Buia-Dev/PulseDash/Obsidian/Pulsedash/🏆 Log de Conquistas.md

# 🏆 Log de Conquistas

> Registro das vitórias técnicas mais importantes. Cada entrada aqui custou horas de debug, testes no carro e determinação. Não é programador, mas resolve! 💪

---

## 🥇 A Grande Conquista — CAN Bus Nativo (2026-05-16)

**O que foi:** Descartamos completamente o ELM327 Bluetooth e implementamos leitura **direta** da rede CAN do Onix 2026 usando o driver TWAI nativo do ESP32 com o módulo SN65HVD230.

**Por que é difícil:** O Onix 2026 usa um **Security Gateway** da GM que ignora frames CAN de 11-bit (padrão). Somente o endereçamento **Extended de 29-bit** com o endereço específico `0x18DB33F1` consegue comunicação.

**O momento:** Após horas de debug com logs de "ECU em silêncio", a tela mostrou:
```
[CAN] Handshake OK! ECU detectada: 0x18daf111
[CAN] ★ ONLINE! Dashboard ativo.
```

**Dados confirmados em tempo real:**
- Temperatura: **35°C** (motor frio) → **90°C** (temperatura normal)
- Acelerador: mudou de **43% → 26%** conforme o pedal foi liberado
- RPM máximo registrado: **6.418 RPM**
- Velocidade máxima registrada: **115 km/h**

---

## 🥈 Descoberta do GND do Chassi (2026-05)

**O que foi:** Semanas de frustração com "Driver OK mas sem resposta da ECU". O motivo era simples mas invisível: faltava conectar o **GND do pino 4/5 do OBD2** ao GND do ESP32.

**Lição:** Em sistemas CAN, o GND é a referência para os níveis de tensão diferencial (CAN-H e CAN-L). Sem ele, o transceiver literalmente não "vê" os bits.

---

## 🥉 Curto CAN-H/CAN-L (2026-05)

**O que foi:** Mesmo com o GND conectado, o driver entrava em Bus-Off imediato. A causa foi um curto físico nas pistas da PCB do conector OBD2 que havíamos adquirido.

**Solução:** Raspagem manual das pistas de cobre com uma chave de fenda até o curto desaparecer. Depois disso, o barramento estabilizou.

---

## 🎖️ Modularização do Frontend (v4.0)

**O que foi:** O arquivo `index.html` tinha crescido para quase 60KB com todo o CSS e JS embutido — impossível de manter. Dividimos em `state.js`, `renderers.js`, `editor.js` e `main.js`.

**Resultado:** Cada arquivo tem uma responsabilidade única. O código ficou 10x mais fácil de editar.

---

## 🎖️ PWA Funcional no Celular

**O que foi:** O dashboard agora pode ser instalado como app na tela inicial do celular (iOS e Android). Funciona com ícone personalizado, tela cheia sem barra do navegador e cache offline via Service Worker.

**Resultado:** Experiência idêntica a um app nativo sem precisar publicar na App Store.

---

## 🎖️ WebSocket em Tempo Real (v4.1 → v5.0)

**O que foi:** Migramos do polling HTTP (requisição a cada 1 segundo) para **WebSocket** (porta 81). O ESP32 empurra os dados automaticamente a cada 100ms.

**Resultado:** Os ponteiros do dashboard ficaram "vivos" — sem o salto brusco de 1 em 1 segundo.

---

## 🎖️ Integração e Ativação Plena das Ferramentas MCP (2026-05-20)

**O que foi:** Diagnosticamos e eliminamos os gargalos de execução nos servidores MCP integrados à IDE. Criamos a pasta global NPM em `AppData\Roaming\npm`, atualizamos o Node.js para **v24.15.0** e ativamos o Docker Desktop para o `github-mcp-server`.

**Resultado:** Ambos os servidores MCP estão 100% ativos, permitindo o pair-programming de IA no mais alto nível de engenharia.

---

## 🎖️ v6.2 — Sessão Épica de 3 Fases (2026-05-23)

Esta sessão foi a mais importante e produtiva do projeto. Dividida em 3 fases de implementação.

---

### ⚡ Fase 1 — Análise Claude + Refatoração Arquitetural

**O que foi:** O Claude deu uma nota **9.6/10** ao projeto e indicou o caminho para prepará-lo para o APK. Executamos todas as suas sugestões de alta prioridade:

**Extração de módulos de `main.js` (era 1.035 linhas → agora modular):**
- `trip.js` — Todo o Computador de Bordo (TRIP: distância, combustível, custo, timers)
- `perf.js` — Cronômetro 0-100 com state machine (IDLE→WAIT_STOP→READY→RUNNING→DONE), Top 5, histórico
- `transport.js` — Camada de abstração de comunicação (Bluetooth Serial nativo vs. WebSocket)

**Sistema de Orientações (Portrait/Landscape independentes):**
- Criado o objeto `orientations: { portrait: [...], landscape: [...] }` no estado global
- Cada orientação tem seu próprio layout de widgets completamente independente
- `swapOrientation()` refeito para limpar apenas camadas específicas, eliminando duplicação

**Correção do bug `w._sv` (suavização):**
- `saveToESP()` agora deleta `w._sv` antes de serializar a config
- `applyConfig()` limpa o `_sv` ao trocar de sensor para evitar suavização de valor errado

**UDS Service 22 (PIDs Proprietários GM):**
- `canReadUDS()` implementado para Temp. Câmbio (`0x1940`), Pressão Óleo (`0x115C`), Temp. Óleo (`0x1154`)
- `canSendUDS()` com frame correto de 8 bytes e endereço físico `0x18DA11F1`

**Fallback de Consumo Flex Estequiométrico:**
- Quando PID `0x5E` falha, calcula via MAF + Etanol%:
  - AFR dinâmico: `14.7*(1-eth) + 9.0*eth`
  - Densidade real: `737*(1-eth) + 789*eth` g/L
  - Resultado em L/h correto para qualquer mistura E0-E100

**Slosh Mitigation (mitigação de balanço do tanque):**
- 3 modos: Fast-Fill (abastecimento), Bloqueio Inercial (frenagem/aceleração), Suavização lenta (cruzeiro)
- Algoritmo EMA com pesos diferentes por cenário

---

### 🐛 Fase 2 — Debug de UI e Build do APK

**O que foi:** Série de bugs visuais e de build foram identificados e corrigidos:

**Ícones do APK com XML corrompido:**
- `ic_launcher.xml` e `ic_launcher_round.xml` tinham BOM UTF-8 que causava `XMLStreamException`
- Recriados do zero com XML limpo e layer-list correto

**Imagens personalizadas da galeria:**
- Usuário pode adicionar imagens da galeria do celular como fundo de relógio
- `LOCAL_IMAGES` expandido com suporte a `pulsedash_custom_images` no localStorage
- Mover, redimensionar e deletar imagens customizadas funcionando

**Duplicação de relógios ao girar o celular:**
- `swapOrientation()` chamava `innerHTML = ''` no container inteiro
- Corrigido para limpar apenas `wl-0`, `wl-1`, etc. (camadas específicas)

**Cores dos arcos/agulhas não salvavam:**
- `applyConfig()` pegava valores de inputs ocultos (`display:none`) e sobrescrevia as cores corretas
- Corrigido com filtro `if (input.offsetParent !== null)` antes de ler o valor

**Fontes +2px em tudo:**
- Script varreu `style.css` e incrementou em 2px todos os `font-size` do menu, overlays e etiquetas

**Botão ↔ no Editor:**
- Restaurado no cabeçalho do `#cpanel`
- `document.getElementById('cpanel').classList.toggle('right')` — alterna lado instantaneamente

---

### 🔧 Fase 3 — Compilação, Correção de Runtime e Teste no Carro

**O que foi:** Integração do `arduino-cli`, correção dos últimos bugs de runtime e validação final em pista.

**`arduino-cli` integrado ao Antigravity:**
- Download e configuração do core `esp32:esp32@3.3.8`
- Correção do `}` faltando no final da função `loop()` (engolido numa refatoração)
- Compilação bem-sucedida: **1.119.484 bytes (85% do flash)**, 42.136 bytes RAM (12%)
- Firmware `.bin` gerado em `APK/Firmware/PulseDashESP_BT.ino.bin`

**Bug `Script error. Linha: 0:0` (tela vermelha ao conectar BT):**
- Falso positivo do Android WebView ao carregar módulos ES6 com `import/export`
- O `window.onerror` recebia o evento sem arquivo, linha ou stack (segurança do browser)
- Fix: `if (e.message === 'Script error.' || (!e.filename && e.lineno === 0)) return;`

**Bug `_freqHz is not defined` (crash no menu OBD):**
- Variáveis `_freqHz`, `_freqCounter`, `_freqTimer`, `_blinkTimer` foram perdidas numa refatoração
- Declaradas no escopo global do `main.js`

**Repositório oficial sincronizado:**
- `PulseDashESP_BT/` contém apenas o `PulseDashESP_BT.ino` (sem pasta `data` do LittleFS)
- `APK/` contém `PulseDash_v6.2.apk` e `Firmware/PulseDashESP_BT.ino.bin`

**✅ TESTE NO CARRO — RESULTADO:** `"ja ta lendo certim"` — Buia, 2026-05-23

---

## 📊 Linha do Tempo do Projeto

```
[v1-v2] Canvas + Widgets simulados (sem hardware)
   ↓
[v3.x]  Integração ELM327 Bluetooth — funcionou mas com alta latência
   ↓
[v4.0]  Modularização JS + WebSocket + PWA
   ↓
[v5.0]  ★ MIGRAÇÃO TOTAL para CAN Bus 29-bit nativo
   ↓
[v5.1]  Otimizações de performance (100ms timeout, 20ms delay, 10 tentativas)
   ↓
[v5.4.1] Suavização por ponteiro, cronômetro 0-100
   ↓
[v6.0]  App Android nativo + Bluetooth Classic RFCOMM + Scheduler 10 slots
   ↓
[v6.2]  ★ SESSÃO ÉPICA: 3 fases — Arquitetura + Debug UI + Compilação CLI
         ★ PRIMEIRA SAÍDA DE RUA — Leitura confirmada no Onix 2026
   ↓
[v6.3]  Remoção de shadowBlur (Thermal Throttling) e Lazy Render otimizado
   ↓
[v6.4]  Separação de utils.js (Fim da dependência circular e silent crashes no Boot)
   ↓
[v6.6]  Fase de Performance Extrema e Otimização GPU (60FPS WebView sem drop-shadow)
   ↓
[v6.9]  ★ INTEGRAÇÃO DE AGULHAS & RELEASE DO APK v6.9 (16 agulhas, JBR compiler)

---

## 🎖️ A Batalha contra o Android WebView (v6.3 / v6.4)

**O que foi:** O app entrava em _thermal throttling_ após minutos de uso e congelava a tela no boot intermitentemente.
- **Thermal Throttling:** Identificamos que o `ctx.shadowBlur` nos Canvas causava um overhead colossal sem aceleração nativa na GPU, derretendo o CPU do celular. A remoção resolveu os travamentos em tempo de uso. Adicionamos **Lazy Render**, onde o `ctx` só é limpo e redesenhado se a variação do sensor for maior que `0.05`.
- **Silent Boot Crash:** Um erro silencioso e randômico no Android WebView estava ocorrendo devido a uma **Dependência Circular** (ES6 Modules) entre `main.js`, `trip.js` e `transport.js` que usavam o `toast()`. Extraímos tudo para um `utils.js` isolado e os travamentos do boot desapareceram completamente.

---

## 🎖️ Expansão de Performance e UI Premium (v6.5 / v6.6)

**O que foi:** Foco absoluto na fluidez visual, usabilidade do editor e suporte a novos sensores de performance.

**Fase de Editor e Usabilidade (v6.5):**
- **Collision Test Exato (Z-Index):** O clique de seleção no editor passou a priorizar os elementos menores e mais à frente (Point-in-Rectangle hit test com ordenação decrescente de área), facilitando selecionar elementos pequenos sobrepostos a grandes áreas.
- **Scroll e Pinned Buttons no Painel:** O `#cpanel` foi redesenhado com barra de rolagem high-tech interna. Botões de "SALVAR/DELETAR" e o título ficaram fixos (pinned) para sempre estarem visíveis, eliminando problemas de corte na parte inferior.
- **Opções Automáticas por Sensor:** Ao selecionar um sensor (ex: Velocidade, Modo Demo), as opções específicas de correção abrem instantaneamente na edição do widget sem necessidade de reabrir o menu.
- **Inércia Suavizada:** Slider substituído por um dropdown intuitivo (3%, 6%, 9% ou Sem Inércia).
- **Correções Visuais:** O botão "Mover/Travar" parou de sumir, e a borda amarela de seleção foi fixada garantindo retenção de estados pelo `mkWidget()`. E widgets independentes ganharam a própria velocidade de Modo Demo (`w.demoSpeed`).

**Fase de Performance Extrema e Otimização GPU (v6.6):**
- **Novos Sensores PRO:** Implementados decodificadores para `turbo`, `maf`, `oilPress`, `fuelPress`, `oilTemp`, `iat`, `egt`, `afr`, `lambda` e `timing`. Os cálculos de mistura e pressão de turbo já usam decimais nos relógios. Removidos sensores GPS retro para focar 100% no OBD2.
- **60FPS no Android WebView:** Diagnosticamos um grande gargalo na splash screen. O Android WebView congelava/lagava renderizando `-webkit-background-clip: text` junto de `filter: drop-shadow`. 
- **Solução Visual Elegante:** Trocamos todos os drop-shadows por `text-shadow` e `box-shadow`, recuperando os 60FPS estáveis na abertura sem perder a estética neon/synthwave.
- **Pausa Dramática (500ms):** Inserimos 500ms de tela preta pura antes da inicialização visual para evitar o engasgo inicial do aplicativo no celular e permitir que o usuário sempre aprecie a animação de "booting" do zero com sincronia perfeita.

---

**Links:** [[⚙️ Painel de Controle (Home)]] | [[📝 Lista de Tarefas]]  
**Tags:** #conquistas #historico #milestones #canbus #pulsedash

---

## 🎖️ Agulhas Premium & Compilação Autônoma (v6.9 - 2026-06-09)

**O que foi:** Adicionados 16 designs de agulha categorizados e configurados no painel com dropdown Figma-like, além de criar o pipeline de build e sync do APK v6.9.

**Fase de Design e Categorização das Agulhas:**
- **16 Estilos Aprovados:**
  - *Cor Variável:* Neon Glow (original), Traço Fino, Triângulo, Ponta Cor, Halo/Flutuante, Esqueleto GT3, Lâmina Laser.
  - *Cor Fixa:* Retro Cromo, Audi RS Red, Subaru STI Orange, Mercedes-AMG White, Corvette Yellow, Carbon Hex-Arrow.
  - *Pontas (Setas/Halos flutuantes):* Setinha Externa, Double Ring Arrow, Halo Dot, Chevron Sweep, Crosshair Radar, Laser Dot Trail, Diamond Prism, Arc Bracket.
- **Auto-Escala Proporcional:** Criado fator `sf = r / 138` para todas as agulhas.
- **Ajuste de Visibilidade de Pontas (+35%):** Agulhas do grupo "Pontas" receberam escala de ampliação automática de `1.35x` no canvas para melhorar legibilidade e legibilidade mobile.
- **Dropdown Agrupado (`<optgroup>`):** Seletor do editor reestruturado com categorias visuais divididas.

**Fase de Compilação Estável do APK v6.9:**
- **Injeção de Script Automática:** O script `sync.js` foi configurado para injetar `capacitor.js` dinamicamente no boot-file para evitar travamentos de dependências nativas.
- **Bypass de PowerShell Execution Policy:** Executado o sync via CMD (`npx.cmd cap sync android`) para contornar restrições de permissões no Windows.
- **Build de Release Debug v6.9:** Compilação finalizada via linha de comando local utilizando o compilador JDK JBR integrado ao Android Studio. O arquivo gerado foi arquivado em `APK/PulseDashV6.9.apk`.

---

## 🏆 A Grande Evolução — Telemetria Binária & Estabilização Geral (v7.0 - 2026-06-11)

**O que foi:** Expandimos o protocolo de comunicação para telemetria binária pura de 51 bytes, habilitamos 8 novos sensores de performance ativa e eliminamos completamente gargalos de escrita na Flash e JIT no WebView. A nota do projeto chegou em **10/10** no Nível 1.

**O que conquistamos:**
- **8 Novos Sensores Ativos (Prioridade 2):** Pressão e Temp de Óleo, Pressão de Combustível, Temperatura de Escape (EGT), Mistura AFR, Sensor Lambda, Timing de Ignição e Temperatura de Admissão (IAT) integrados com decodificação no firmware e calibração no app.
- **Criação da `fsTask` no Core 0 (Antilag de LittleFS):** Todas as escritas em disco da ESP32 (viagem de 5km, parada de motor, sensores não suportados, escrita de histórico no dia, e perfil do carro) foram movidas para a `fsTask` em segundo plano no Core 0, rodando sob mutex. Isso acabou em definitivo com as quedas bruscas de conexão e lag na telemetria.
- **Mitigação de Fragmentação de Heap (ESP32 Uptime Máximo):** Refatoramos o salvamento do histórico de 7 dias na Flash de Strings Arduino para um buffer estático em RAM `char[1024]` e `snprintf`. Uptime ilimitado sem risco de Out of Memory.
- **Overhead JIT Eliminado no WebView:** Fórmulas de conversão de dados agora usam JIT caching via Map local `formulaCache` no `transport.js`. O compilador `new Function` roda uma única vez por fórmula, poupando bateria e CPU do celular.
- **Interface e Controles Seguros:**
  - Delegação de cliques estáticos no Computador de Bordo (`trip.js`), reduzindo o vazamento de listeners e RAM no WebView.
  - Cancelamento de timers de terminal DTC com `clearDtcTimers()`, evitando o encavalamento de textos e concorrência no DOM.
  - Google DTC dinâmico por marca com `ST.car?.brand`.
- **Compilação e Lançamento do APK v7.0:** O Gradle compilou a versão 7.0 (código 7) sob o JDK do Android Studio e salvamos o APK v7.0 no repositório.

---

**Links:** [[⚙️ Painel de Controle (Home)]] | [[📝 Lista de Tarefas]] | [[🔌 Sensores e Comunicação]]  
**Tags:** #conquistas #historico #milestones #canbus #pulsedash #v70
