Buia-Dev/PulseDash/kline_image.jpg

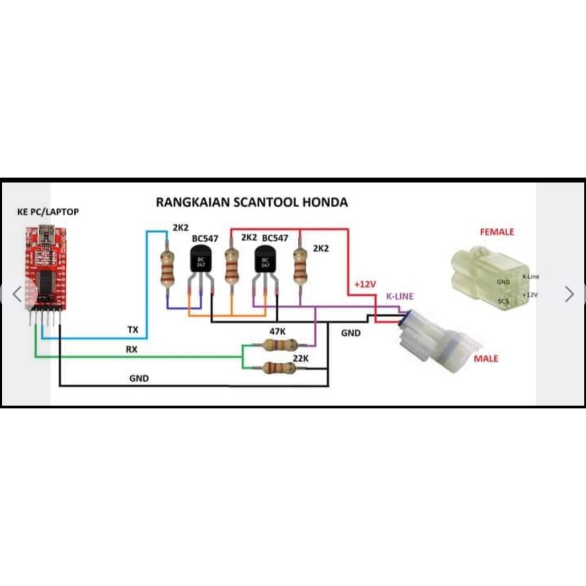
kline_image.jpg
