Buia-Dev/PulseDash/(commit log)

2026-05-20 feat(v6.0): App Android nativo, scheduler circular 10 slots, 15 sensores OBD2
    FIRMWARE (PulseDashESP_BT.ino):
    - Substituido if/else if por scheduler circular de 10 slots (anti-starvation)
    - RPM e Speed lidos a 20Hz (todo ciclo de 50ms)
    - Borboleta e Pedal em slots multiplos para maior frequencia (~6.6Hz)
    - Carga, MAP, MAF, Consumo em slots dedicados (~2Hz)
    - Slot 9 roda 7 sensores lentos em round-robin (Volt, Agua, Catalisador, Ar, Combustivel, Odometro, Etanol)
    - Timeout de PID reduzido de 25ms para 12ms (elimina lag de ciclo)
    - Fallback MAP e Consumo: grava -1 no timeout e recalcula via throttle+load+RPM a cada ciclo (nao congela mais)
    - Removidos: oilTemp, oilPres, transTemp, test (nao su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
2026-05-23 docs(v6.2): sessao epica 23/05 — 3 fases de implementacao + teste no carro confirmado
    FASE 1 — Refatoracao Arquitetural (analise Claude 9.6/10):
    - Extraido trip.js: Computador de Bordo (TRIP) saiu do main.js para modulo proprio
    - Extraido perf.js: Cronometro 0-100 com state machine (IDLE/WAIT_STOP/READY/RUNNING/DONE) + Top5
    - Criado transport.js: abstrai Bluetooth Serial vs WebSocket (initTransport, saveToESP, loadFromESP, saveRecordes)
    - Sistema orientations{portrait/landscape}: layouts 100% independentes por orientacao
    - Fix w._sv: saveToESP() deleta _sv antes de serializar. applyConfig() limpa ao trocar sensor
    - UDS Service 22: canSendUDS() + canReadUDS() — TransTemp(0x1940), OilPre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
2026-06-11 fix: resolve scope compilation error of triggerSaveHistory
    [PulseDashESP_BT.ino]
2026-06-11 fix: resolve binary parser size mismatch and temperature overflows
    [PulseDashESP_BT.ino]
2026-06-11 fix: ignore ECU sensors in telemetry when connection state is not ONLINE
